sincerelystepper/AgriGuard-RES-Reconfigurable-Edge-Sentinel-/Hardware/images/pcb back 3d render .gif

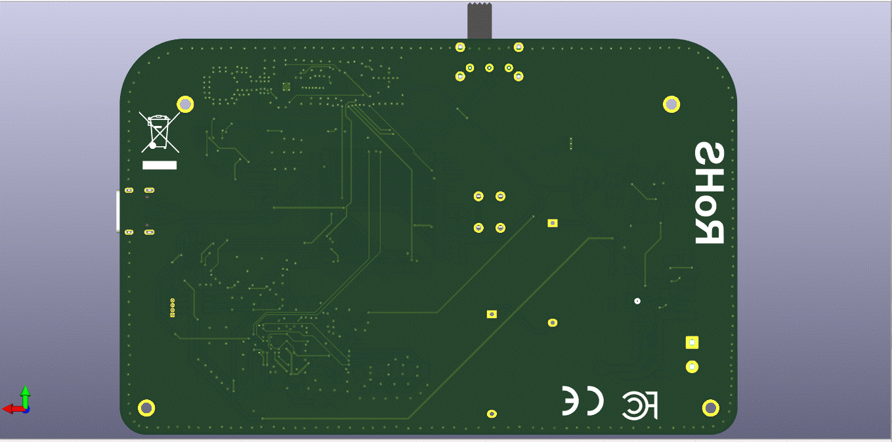
Hardware/images/pcb back 3d render .gif
