sincerelystepper/AgriGuard-RES-Reconfigurable-Edge-Sentinel-/Hardware/images/sx1262  RF routing 2d.gif

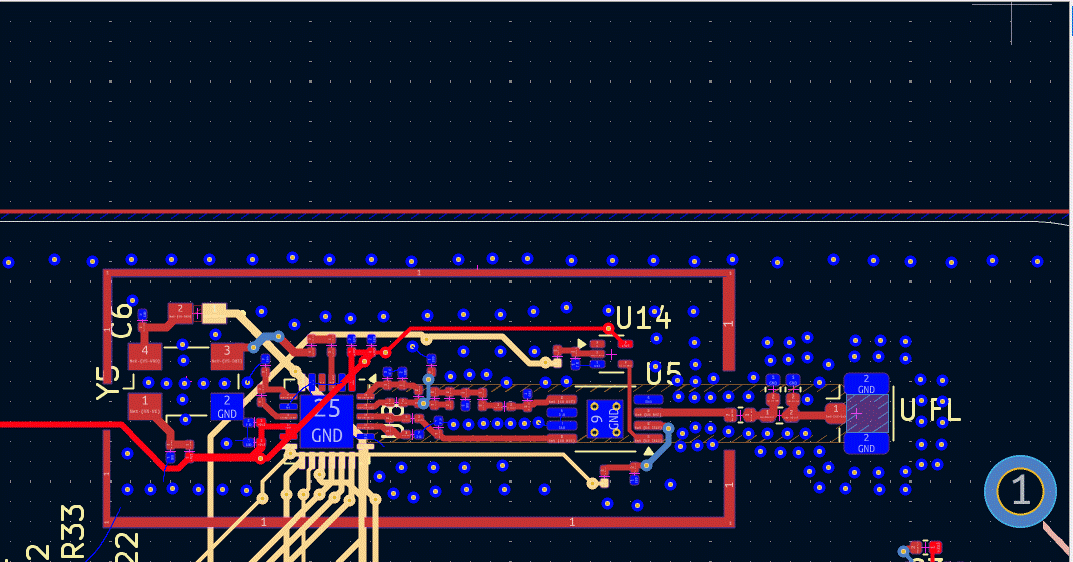
Hardware/images/sx1262 RF routing 2d.gif
