sincerelystepper/AgriGuard-RES-Reconfigurable-Edge-Sentinel-/Hardware/images/sx1262 RF routing 3d.gif

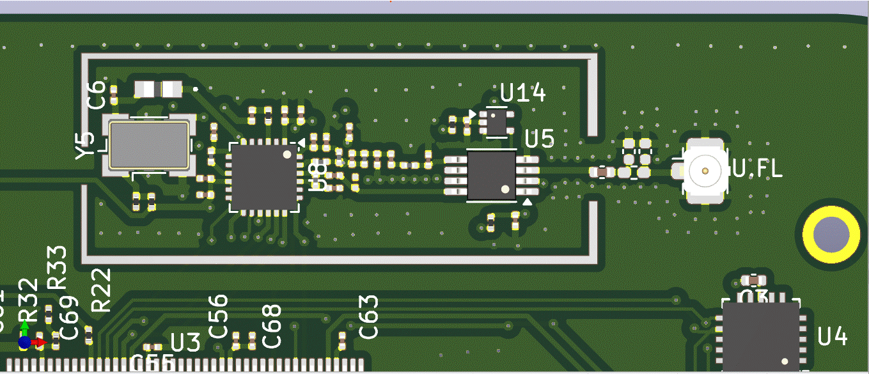
Hardware/images/sx1262 RF routing 3d.gif
