sincerelystepper/AgriGuard-RES-Reconfigurable-Edge-Sentinel-/Fabrication/gerber jlcpcb pic.gif

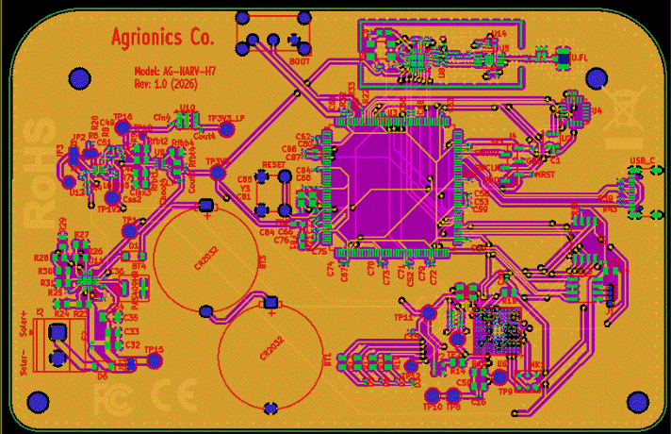
Fabrication/gerber jlcpcb pic.gif
