sincerelystepper/AgriGuard-RES-Reconfigurable-Edge-Sentinel-/Fabrication/jlcpcb 2d back pic.gif

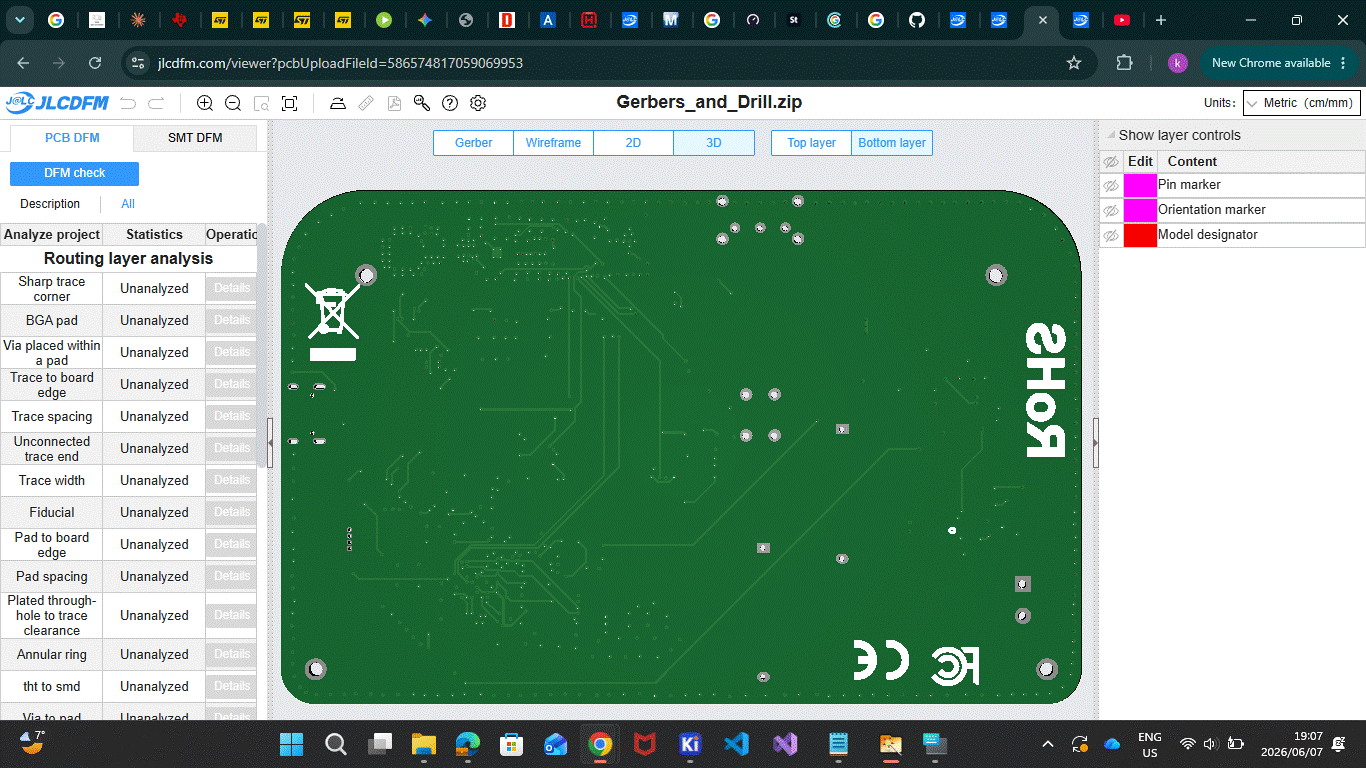
Fabrication/jlcpcb 2d back pic.gif
