sincerelystepper/AgriGuard-RES-Reconfigurable-Edge-Sentinel-/Fabrication/jlcpcb 2d front pic.gif

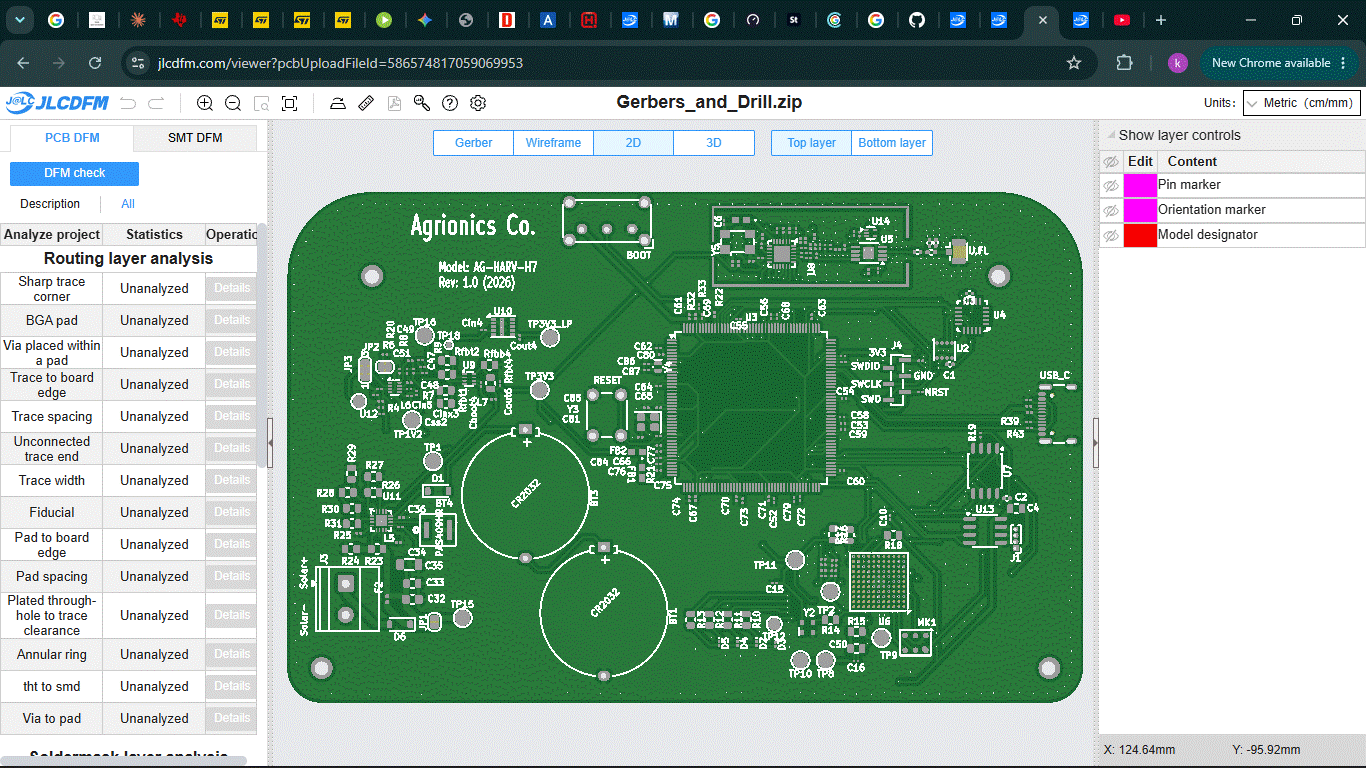
Fabrication/jlcpcb 2d front pic.gif
