sincerelystepper/AgriGuard-RES-Reconfigurable-Edge-Sentinel-/Fabrication/jlcpcb gerber front pic.gif

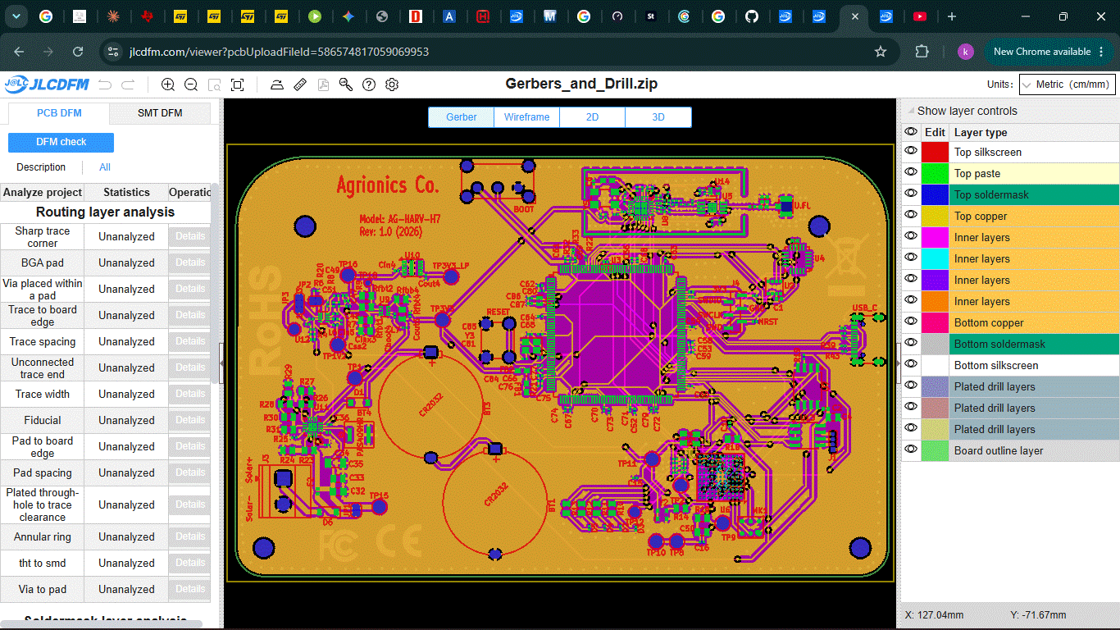
Fabrication/jlcpcb gerber front pic.gif
