sincerelystepper/AgriGuard-RES-Reconfigurable-Edge-Sentinel-/Fabrication/jlcpcb wireframe front pic.gif

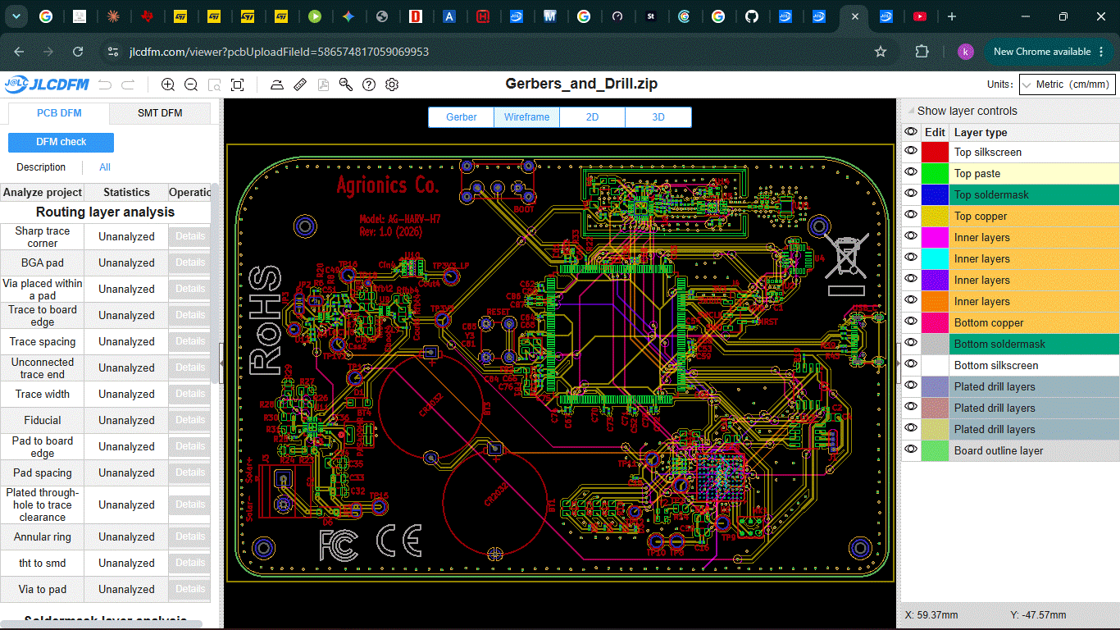
Fabrication/jlcpcb wireframe front pic.gif
