sincerelystepper/AgriGuard-RES-Reconfigurable-Edge-Sentinel-/HDL_FPGA/simulation_images/hdl_wave_verification_HIL.png

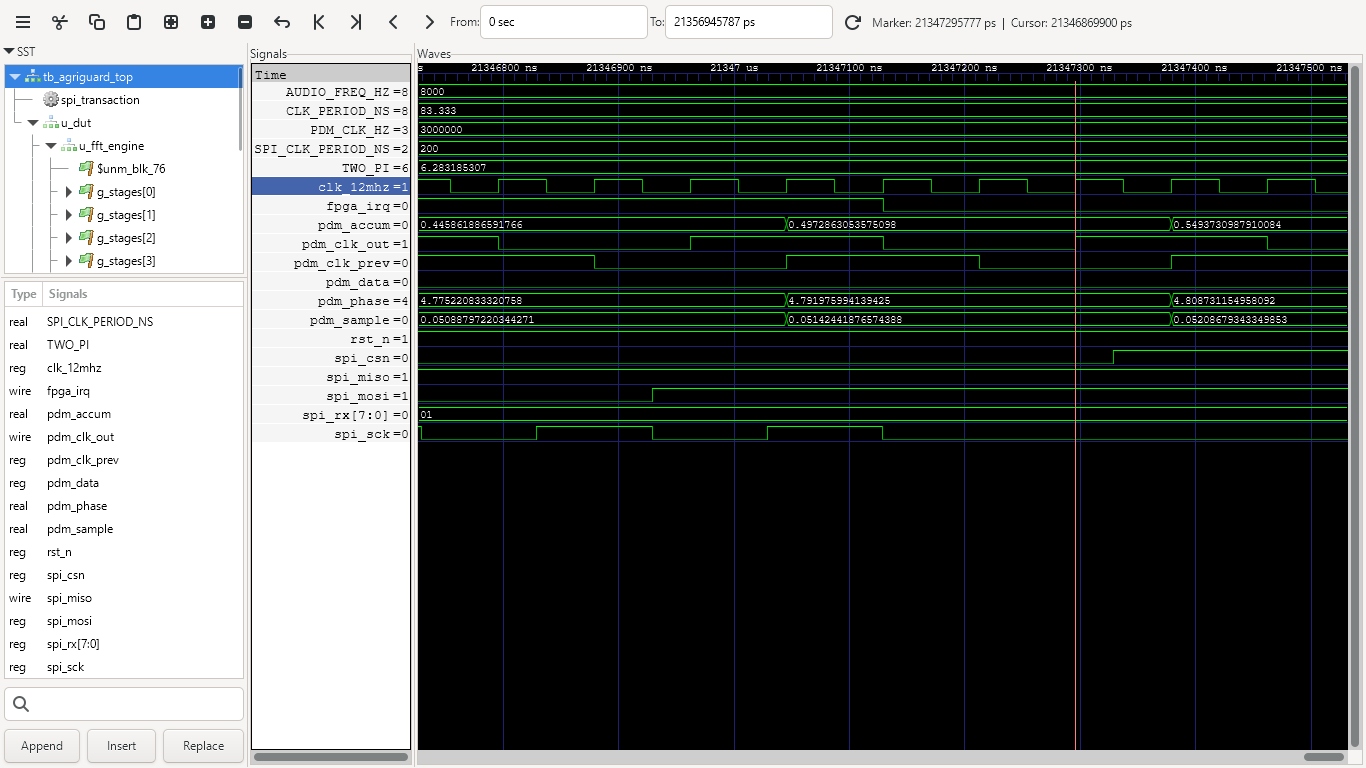
HDL_FPGA/simulation_images/hdl_wave_verification_HIL.png
