sincerelystepper/AgriGuard-RES-Reconfigurable-Edge-Sentinel-/Firmware_MCU/AgriGuard_RES/AgriGuard_RES.ioc

Mcu.UserName=STM32H743IITx
PA0.Signal=GPIO_Input
PA1.Signal=GPIO_Input
PA10.Signal=USB_OTG_FS_ID
PA11.Signal=USB_OTG_FS_DM
PA12.Signal=USB_OTG_FS_DP
PA2.Signal=GPIO_Analog
PA3.Signal=GPIO_Analog
PA4.GPIO_Label=SPI_LORA_CS
PA4.Signal=GPIO_Output
PA5.Signal=SPI6_SCK
PA6.Signal=GPIO_Analog
PA7.Signal=GPIO_Analog
PA8.Signal=GPIO_Analog
PA9.Signal=USB_OTG_FS_VBUS
PB0.Signal=GPIO_Analog
PB1.Signal=GPIO_Analog
PB10.Signal=GPIO_Analog
PB11.Signal=GPIO_Analog
PB12.Signal=SPI2_NSS
PB13.Signal=SPI2_SCK
PB14.Signal=UART4_DE
PB15.Signal=SPI2_MOSI
PB2.Signal=GPIO_Analog
PB5.Signal=SPI6_MOSI
PB6.Signal=I2C1_SCL
PB7.Signal=I2C1_SDA
PB8.Signal=GPIO_Analog
PB9.Signal=GPIO_Analog
PC0.Signal=GPIO_Analog
PC1.Signal=GPIO_Analog
PC10.Signal=UART4_TX
PC11.Signal=UART4_RX
PC12.Signal=GPIO_Analog
PC13.Signal=GPIO_Analog
PC2_C.Signal=ADC3_INP0
PC3_C.Signal=GPIO_Analog
PC4.Signal=GPIO_Analog
PC5.Signal=GPIO_Analog
PC6.Signal=GPIO_Analog
PC7.Signal=GPIO_Analog
PC8.Signal=GPIO_Analog
PC9.Signal=GPIO_Analog
PD0.Signal=GPIO_Analog
PD1.Signal=GPIO_Analog
PD10.Signal=GPIO_Analog
PD11.Signal=GPIO_Analog
PD12.Signal=GPIO_Analog
PD13.Signal=GPIO_Analog
PD14.Signal=GPIO_Analog
PD15.Signal=GPIO_Analog
PD2.Signal=GPIO_Analog
PD3.Signal=GPIO_Analog
PD4.Signal=GPIO_Analog
PD5.Signal=GPIO_Analog
PD6.Signal=GPIO_Analog
PD7.Signal=GPIO_Analog
PD8.Signal=GPIO_Analog
PD9.Signal=GPIO_Analog
PE0.Signal=GPIO_Analog
PE1.Signal=GPIO_Analog
PE10.Signal=GPIO_Analog
PE11.Signal=GPIO_Analog
PE12.Signal=GPIO_Analog
PE13.Signal=GPIO_Analog
PE14.Signal=GPIO_Analog
PE15.Signal=GPIO_Analog
PE2.Signal=GPIO_Analog
PE3.Signal=GPIO_Analog
PE4.Signal=GPIO_Analog
PE5.Signal=GPIO_Analog
PE6.Signal=GPIO_Analog
PE7.Signal=GPIO_Analog
PE8.Signal=GPIO_Analog
PE9.Signal=GPIO_Analog
PF10.Signal=GPIO_Analog
PF11.Signal=GPIO_Analog
PF12.Signal=GPIO_Analog
PF13.Signal=GPIO_Analog
PF14.Signal=GPIO_Analog
PF15.Signal=GPXTI15
PF2.Signal=GPIO_Analog
PF3.Signal=GPIO_Analog
PF4.Signal=GPIO_Analog
PF5.Signal=GPIO_Analog
PF6.Signal=GPIO_Analog
PF7.Signal=GPIO_Analog
PF8.Signal=GPIO_Analog
PF9.Signal=GPIO_Analog
PG0.Signal=GPIO_Analog
PG1.Signal=GPIO_Analog
PG10.Signal=GPIO_Analog
PG11.GPIO_Label=FPGA_RESET
PG11.Signal=GPIO_Output
PG12.GPIO_Label=FPGA_INIT
PG12.Signal=GPIO_Input
PG13.GPIO_Label=FPGA_DONE
PG13.Signal=GPIO_Input
PG14.Signal=GPIO_Output
PG15.Signal=GPIO_Analog
PG2.Signal=GPIO_Analog
PG3.Signal=GPIO_Analog
PG4.Signal=GPIO_Analog
PG5.Signal=GPIO_Analog
PG6.Signal=GPIO_Analog
PG7.Signal=GPIO_Analog
PG8.Signal=GPIO_Analog
PG9.Signal=GPIO_Analog
PH10.Signal=GPIO_Analog
PH11.Signal=GPIO_Analog
PH12.Signal=GPIO_Analog
PH13.Signal=GPIO_Analog
PH14.Signal=GPIO_Analog
PH15.Signal=GPIO_Analog
PH2.Signal=GPIO_Analog
PH3.Signal=GPIO_Analog
PH4.Signal=GPIO_Analog
PH5.Signal=GPIO_Analog
PH6.Signal=GPIO_Analog
PH7.Signal=GPIO_Analog
PH8.Signal=GPIO_Analog
PH9.Signal=GPIO_Analog
PI0.Signal=GPIO_Analog
PI1.Signal=GPIO_Analog
PI10.Signal=GPIO_Analog
PI11.Signal=GPIO_Analog
PI2.Signal=SPI2_MISO
PI3.Signal=GPIO_Analog
PI4.Signal=GPIO_Analog
PI5.Signal=GPIO_Analog
PI6.Signal=GPIO_Analog
PI7.Signal=GPIO_Analog
PI8.Signal=GPIO_Analog
PI9.Signal=GPIO_Analog
