sincerelystepper/AgriGuard-RES-Reconfigurable-Edge-Sentinel-/Firmware_MCU/AgriGuard_RES/Core/Inc/main.h

#define SPI_LORA_CS_Pin GPIO_PIN_4
#define SPI_LORA_CS_GPIO_Port GPIOA
#define FPGA_RESET_Pin GPIO_PIN_11
#define FPGA_RESET_GPIO_Port GPIOG
#define FPGA_INIT_Pin GPIO_PIN_12
#define FPGA_INIT_GPIO_Port GPIOG
#define FPGA_DONE_Pin GPIO_PIN_13
#define FPGA_DONE_GPIO_Port GPIOG
