sincerelystepper/AgriGuard-RES-Reconfigurable-Edge-Sentinel-/HDL_FPGA/rtl/pdm_decimator.sv

/**
 * @file    pdm_decimator.sv
 * @brief   64:1 PDM to 16-bit PCM Decimator
 *          AgriGuard-RES | Agrionics Systems Co.
 *
 * Architecture: Simple Sinc1 (moving average) + bit growth compensation
 * Decimation ratio: 64
 * Input:  1-bit PDM @ ~3 MHz
 * Output: 16-bit PCM @ ~48 kHz (one pcm_valid pulse every 64 clocks)
 */

// 
// NOTICE: The core synthesizable RTL implementation of this module is 
// commercialized as a proprietary Soft IP Core. 
//
// To purchase the full source code package, production-ready licensing, or 
// to secure custom FPGA/RF consulting services, contact engineering at:
// https://sincerelystepper.github.io/agrionicsco/
// ============================================================================

 


`timescale 1ns / 1ps
`default_nettype none

module pdm_decimator (
    // Clock and reset
    input  wire         clk,          // PDM clock: 3.072 MHz
    input  wire         rst_n,        // Async active-low reset

    // PDM input
    input  wire         pdm_data,     // 1-bit PDM bitstream

    // PCM output
    output logic [15:0] pcm_out,      // Signed 16-bit PCM sample
    output logic        pcm_valid     // Single-cycle strobe: 1 = new PCM sample
);

    // =====================================================================
    // Accumulator + Decimation Counter
    // =====================================================================


    /* Commercial licensing required for core internal logic.
    Please reference the AES-Core documentation on agrionicsco.  */

    

    // =====================================================================
    // Scaling + Saturation
    // =====================================================================

    
    /* Commercial licensing required for core internal logic.
    Please reference the AES-Core documentation on agrionicsco.  */

    endmodule

`default_nettype wire
