sincerelystepper/AgriGuard-RES-Reconfigurable-Edge-Sentinel-/(commit log)

2026-06-04 Revise README with detailed project specifications
    Expanded project overview and detailed hardware specifications for the AG-HARV-H7 platform, including power architecture, dual-chip co-processing, RF design, and validation steps.
2026-06-04 Update print statement from 'Hello' to 'Goodbye'
2026-06-04 Clarify SPI interface and RF output in README
    Updated README to specify SPI interface and RF output connection.
2026-06-04 Add files via upload
    Kicad full hierarchical schematic - Power Management and Regulation, STM32H743IITx, ICE40HX8K-BG121, SX1262 868MHz, and Soil Sensors (MP45DT02, AS7261, MAX3485, BME680)
2026-06-10 Add STM32H7 HAL firmware to Firmware_MCU folder
2026-06-10 Fix directory structure: flattened HDL_FPGA folder
    [agriguard_res.pcf, agriguard_top.sv, fft_engine.sv, pdm_decimator.sv, spi_slave.sv, tb_agriguard_top.sv, tb_pdm_decimator.sv, tb_spi_slave.sv]
2026-06-11 Include 3D render image in README
    Add a 3D render image of the AgriGuard-RES front assembly to the README.
2026-06-15 Add README for Software-in-the-Loop (SIL) project
    Added README.md for Software-in-the-Loop (SIL) verification, detailing STM32H743IIT6 and iCE40HX8K-BG121 protocol validation, architectural rationale, and protocol transaction map.
2026-06-15 Add build instructions for OSS CAD Suite and MSYS2
2026-10-06 Add agriguard_bringup.py for STM32H743 bring-up
2026-10-06 Add README for AgriGuard-RES Bring-Up Test Bench
    Added README.md for the AgriGuard-RES Bring-Up Test Bench, detailing usage, requirements, current and planned tests, and repository layout.
2026-10-06 Revise status update in README.md
    Updated the status section to reflect ongoing testing stages.
