sincerelystepper/AgriGuard-RES-Reconfigurable-Edge-Sentinel-/(notices)

Notices in the files:
Firmware_MCU/AgriGuard_RES/Core/Inc/main.h:
Copyright (c) 2026 STMicroelectronics.
All rights reserved.
This software is licensed under terms that can be found in the LICENSE file
